mahak867/unskinny/out/unskinny_mk2_assembly.step

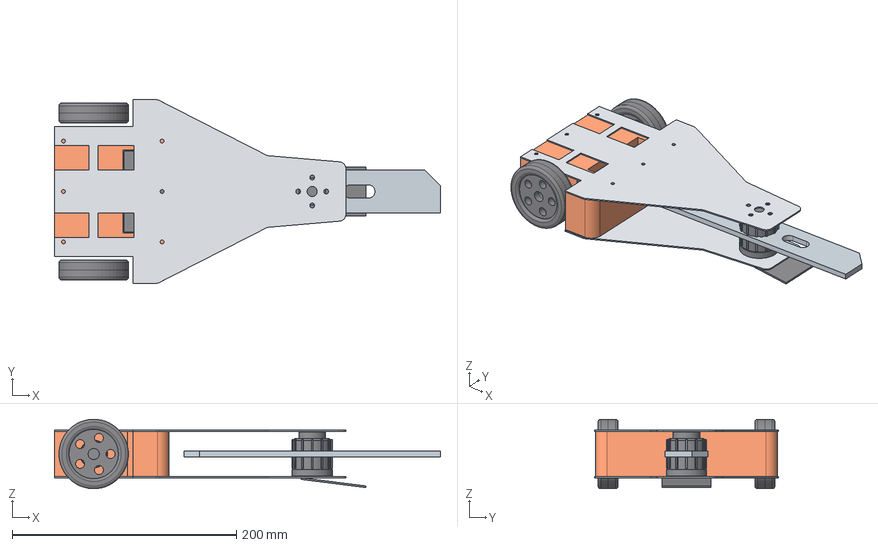
[picture p19: CAD file, 2026-11-07]
out/unskinny_mk2_assembly.step
344.5 x 164.0 x 62.0 mm
bar
top_plate
bottom_plate
frame
fork
hub_motor
battery
wheel_0
wheel_1
drive_0
drive_1
