mahak867/unskinny/out/bar.step

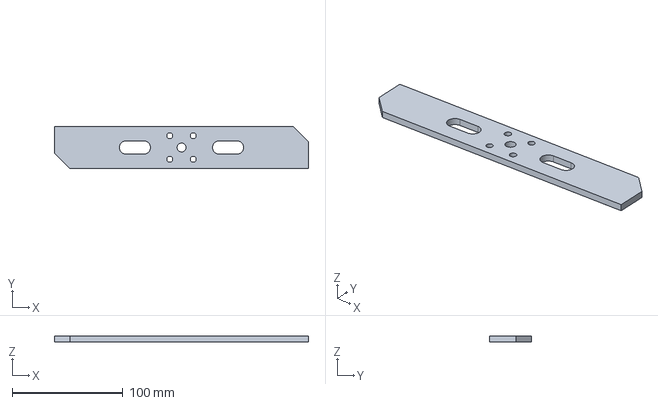
[picture p20: CAD file, 2026-11-07]
out/bar.step
229.0 x 38.0 x 5.00 mm
