mahak867/unskinny/out/frame.step

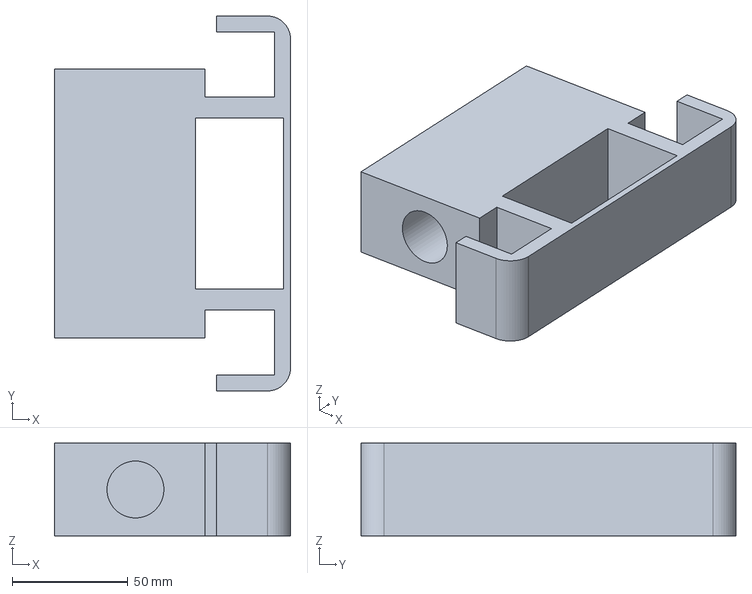
[picture p21: CAD file, 2026-11-07]
out/frame.step
102.0 x 162.0 x 40.0 mm
