mahak867/unskinny/out/bottom_plate.step

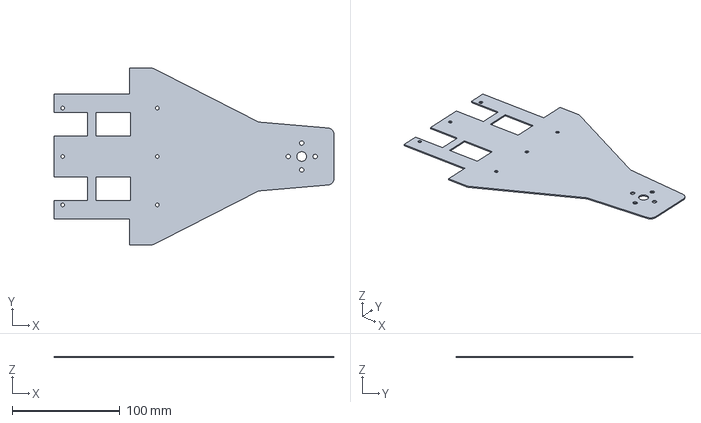
[picture p22: CAD file, 2026-11-07]
out/bottom_plate.step
260.0 x 164.0 x 1.20 mm
