mahak867/unskinny/out/wheel_0.stl

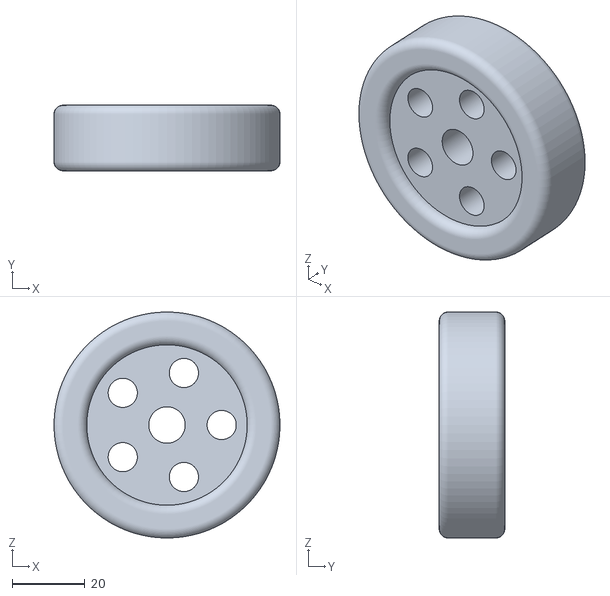
[picture p23: CAD file, 2026-11-07]
out/wheel_0.stl
62.0 x 18.0 x 62.0
