mahak867/unskinny/out/detail_switch.stl

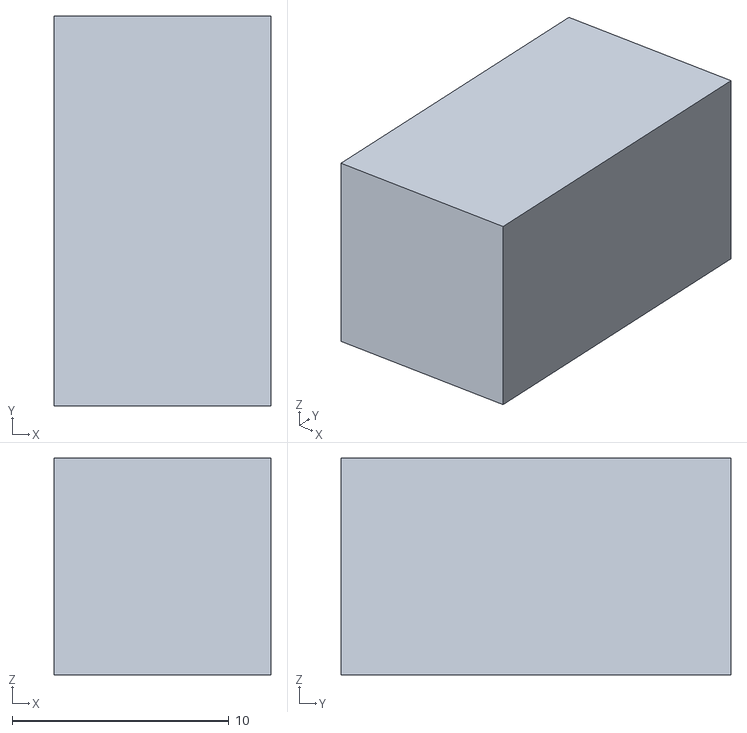
[picture p24: CAD file, 2026-11-07]
out/detail_switch.stl
10.0 x 18.0 x 10.0
