mahak867/unskinny/out/detail_esc_1.stl

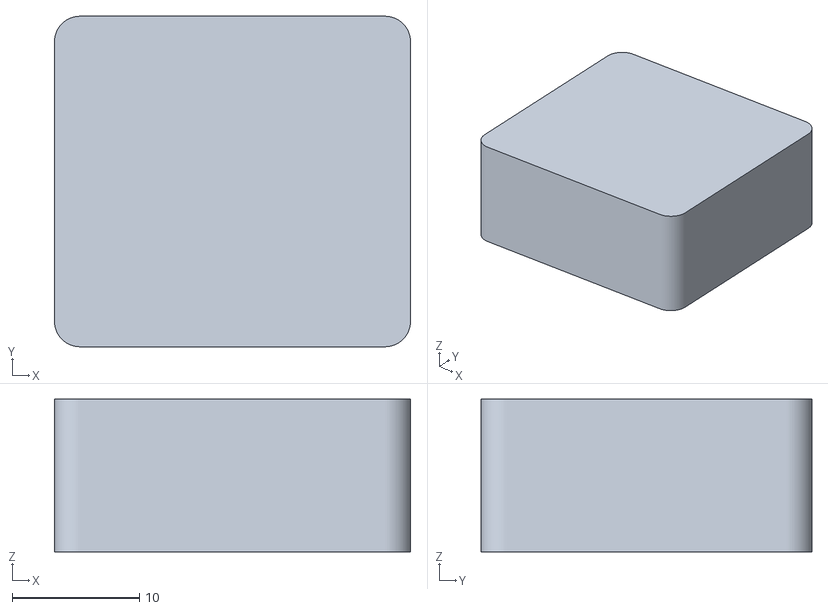
[picture p25: CAD file, 2026-11-07]
out/detail_esc_1.stl
28.0 x 26.0 x 12.0
