mahak867/unskinny/out/hub_motor.stl

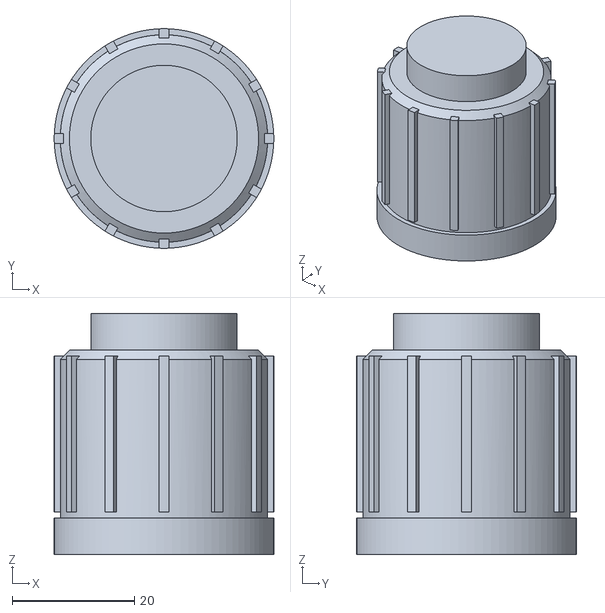
[picture p26: CAD file, 2026-11-07]
out/hub_motor.stl
36.0 x 36.0 x 39.5
