mahak867/unskinny/out/detail_receiver.stl

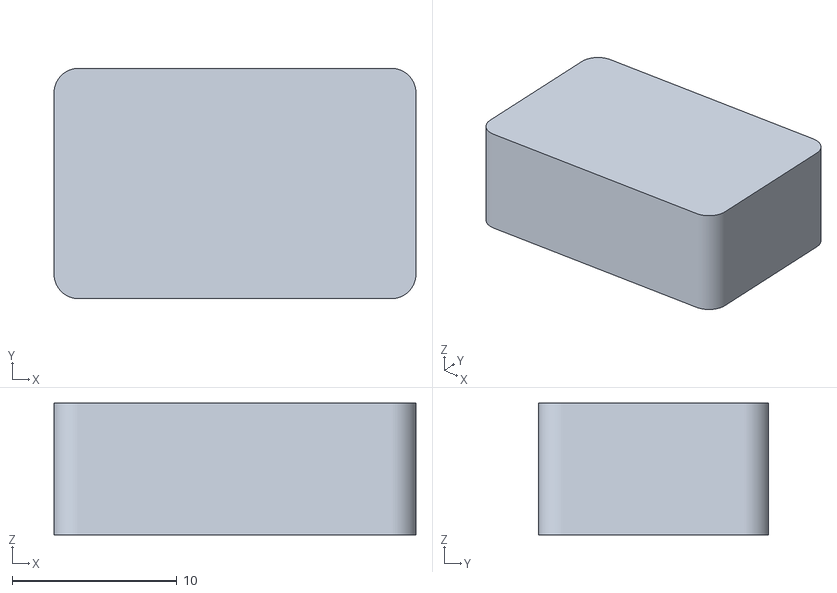
[picture p27: CAD file, 2026-11-07]
out/detail_receiver.stl
22.0 x 14.0 x 8.00
