mahak867/unskinny/out/drive_1.stl

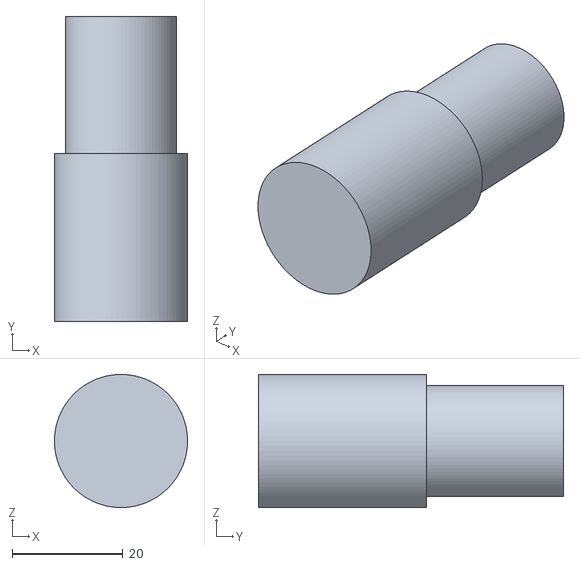
[picture p28: CAD file, 2026-11-07]
out/drive_1.stl
24.0 x 55.0 x 24.0
