mahak867/unskinny/out/battery.stl

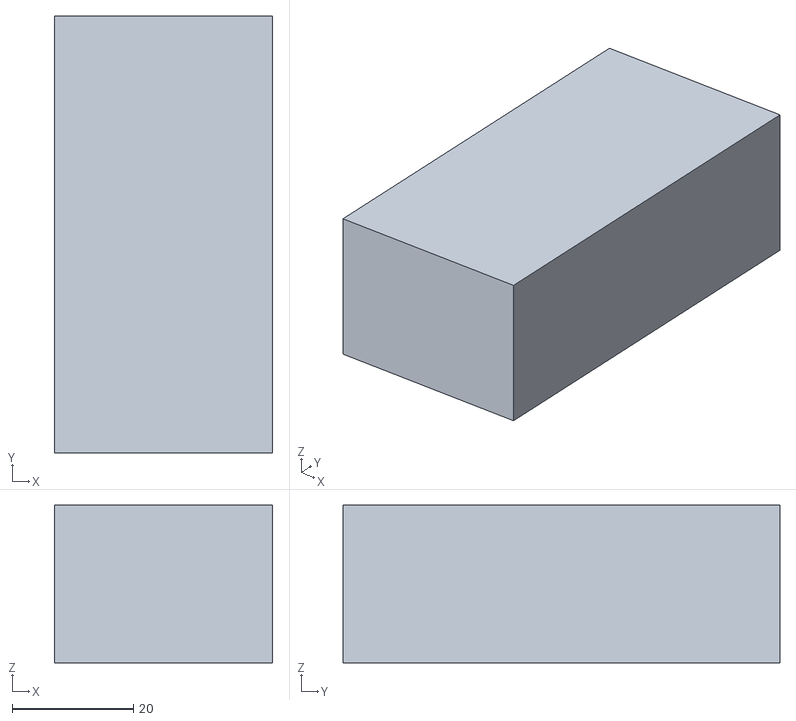
[picture p29: CAD file, 2026-11-07]
out/battery.stl
36.0 x 72.0 x 26.0
