mahak867/unskinny/out/fork.stl

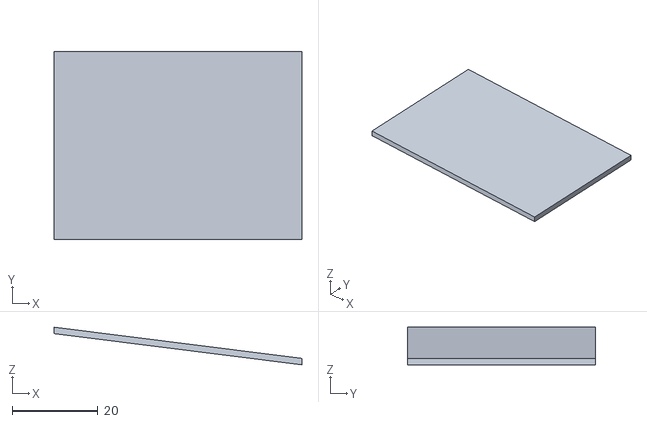
[picture p30: CAD file, 2026-11-07]
out/fork.stl
58.0 x 44.0 x 8.80
