mahak867/unskinny/out/detail_bolts_bottom.stl

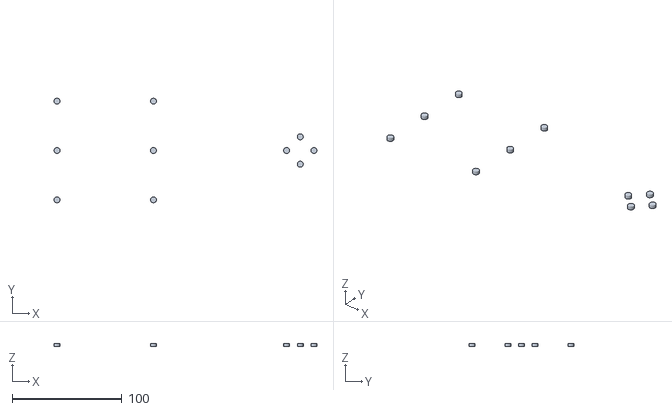
[picture p31: CAD file, 2026-11-07]
out/detail_bolts_bottom.stl
240.0 x 95.5 x 3.00
