mahak867/unskinny/out/detail_bolts_bar.stl

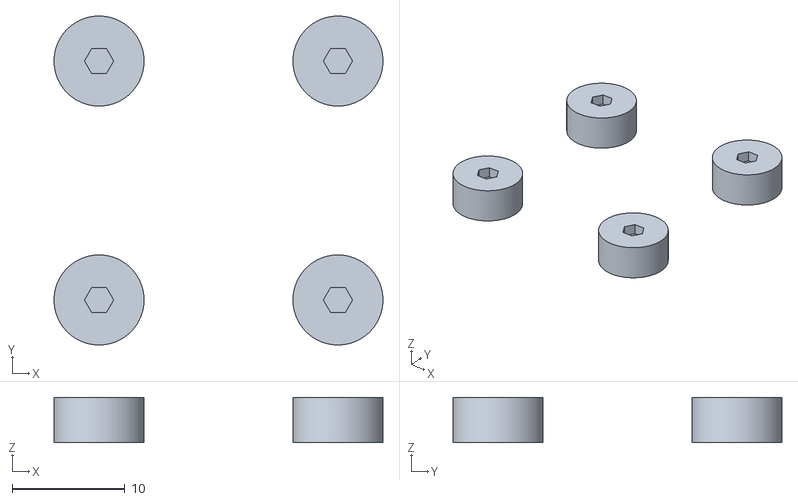
[picture p32: CAD file, 2026-11-07]
out/detail_bolts_bar.stl
29.2 x 29.2 x 4.00
