mahak867/unskinny/(list of files, cad)

Other CAD files:
out/top_plate.step
out/wheel_1.stl
out/drive_0.stl
out/detail_esc_0.stl
out/bar.dxf
out/bar.stl
out/bottom_plate.dxf
out/bottom_plate.stl
out/detail_bolts_top.stl
out/frame.stl
out/top_plate.dxf
out/top_plate.stl
