mahak867/unskinny/showcase/build-pack.html

Mk II redesign · Beetleweight 3 lb (1361 g) · horizontal bar spinner

# Unskinny Bot Build Pack

A ground-up remake of lewisb42's 2013 spinner, using the layout that wins beetleweight events today: a direct-drive brushless weapon on a hub motor, brushless geared drive, 4S power and a hardened steel bar. Everything you need to order, design, build and test is here. Tick boxes as you go; they're saved in this browser.

## 00What changed and why

Top horizontal spinners in current 3 lb brackets (for example Caldera, a horizontal midcutter, and the many bar spinners in the NHRL 2025 Championship qualifier list) share a few traits. Mk II adopts all of them.

2013 original

### Unskinny Mk I

- Belt drive, 1600 kV outrunner, no tensioner
- Aluminum bar, 6 in long
- Brushed B16 drive, 3S 1000 mAh
- Aluminum + UHMW box frame
- Belt jumps off on big hits

Mk II

### Unskinny Mk II

- Direct-drive hub motor (Repeat 2812 class): blade bolts to the motor bell, no belt or pulleys
- Hardened steel bar (AR500 or S7), ~9 in, ~300 g
- Brushless planetary drive (Repeat Max V2 class)
- 4S LiPo for more weapon and drive power
- Thick TPU frame to absorb recoil, titanium top/bottom plates
- Low, invertible profile with replaceable front forks

## 01Target specs

≤ 1340 gtarget weight (21 g margin)

229 × 38 × 5 mmAR500 bar, 304 g (from CAD)

~11,000 rpmweapon speed (simulated)

~940 Jstored weapon energy (simulated)

4S 650 mAhLiPo, 75C+ (enough for a 3 min fight)

260 × 164 × 62 mmbody footprint (from CAD)

These are design targets, not measured numbers. Check the exact kV of the hub motor you buy and rerun the calculator below. Some events cap spinner tip speed or require a test box, so check your rules first.

## 02Weapon calculator

A bar's stored energy is ½·I·ω², with I = m(L² + w²)/12. Change the values to try other bars or motors.

Bar mass (g) Bar length (mm) Bar width (mm) Motor kV Battery (cells) Loaded efficiency (%)

—loaded rpm

—tip speed

—stored energy

—moment of inertia

## 03System layout

flowchart LR
  BAT["4S LiPo 650 mAh"] --> SW["Power switch / link"]
  SW --> DESC["Dual brushless drive ESC"]
  SW --> WESC["Weapon ESC 60–80 A, 4S"]
  DESC --> ML["Left Max V2 drive"]
  DESC --> MR["Right Max V2 drive"]
  WESC --> HUB["2812 hub motor + steel bar"]
  RX["Receiver with failsafe"] -.->|"CH1/CH2 mixed"| DESC
  RX -.->|"CH3"| WESC

The weapon motor sits at the center of the chassis between the top and bottom plates, bolted through both. The battery and ESCs sit in the rear pods behind the drive motors, as far from the weapon as possible. Wheels poke out past both plates slightly so the bot drives either way up.

## 04Bill of materials

Check stock and prices before ordering. Parts listed by class with a known current example. Palm Beach Bots, Repeat Robotics and Fingertech stock most of them.

### Power and motion

Qty | Part | Example | Notes
1 | Brushless hub motor, weapon | Repeat Robotics 2812 Battle Ready Beetle Hubmotor | ~175 g, M5 weapon bolts, M4 mount pattern. Confirm kV
2 | Brushless planetary drive motor | Repeat Robotics Max V2 24 mm (2006, 2100 kV, 27:1) | Rated up to 4S with reversing ESCs
1 | Dual brushless drive ESC | Repeat or DualSky combat dual ESC | Must support reversing and 4S
1 | Weapon ESC, 60–80 A, 4S | BLHeli_32 / AM32 ESC | Set a soft start ramp so you don't brown out the drive
1 | Receiver | Matches your transmitter (FlySky, FrSky, ELRS) | Failsafe required. ELRS gives telemetry
3 | 4S 650 mAh LiPo, 75C+ | GNB, CNHL, Tattu | One in the bot, two charged spares
1 | Power switch or removable link | Fingertech switch or XT30 link | Needs to be reachable with the bot fully assembled
2 + spares | Drive wheels, ~2.25–2.5 in | Fingertech Viper or cast urethane | Hub to match the Max V2 output

### Structure and weapon

Qty | Part | Material | How to make it
1 + spare | Weapon bar, 229 × 38 × 5 mm | AR500 or S7 tool steel, hardened | Waterjet or laser from the DXF, then bevel the impact teeth
2 | Top and bottom plates | Grade 5 titanium, 1.2 mm, tapered and pocketed | Laser/waterjet (SendCutSend, OSH Cut)
1 | Main frame / unibody | TPU 95A, or Nylon-CF for the stiffer middle | 3D print, 4–6 walls, 50%+ gyroid
2 + spares | Front forks / wedgelets | Hardened steel or titanium | Bolt-on, replaceable between fights
1 set | Fasteners | Grade 12.9 M3/M4/M5 socket caps, threaded inserts | Blue threadlocker on all metal-to-metal threads
1 set | Wire, connectors | 14–16 AWG silicone wire, XT30, heat-shrink | Keep runs short

## 05Weight budget

Weigh every part as it arrives and fill in the real numbers. Estimated values are marked "est."

Item | Grams

## 06Design phase (CAD)

- Download STEP models for the hub motor, Max V2 and ESCs (Repeat Robotics publishes CAD on GrabCAD).
- Model the hub motor at the chassis center. Bar clearance should be at least 3 mm to the plates and forks.
- Place drive motors behind the weapon, wheels sticking out past both plates by ~2 mm so the bot drives upside down.
- Pack the battery and ESCs in the rear pods with foam. Leave space for wire bends.
- Design the bar: two impact teeth on opposite ends, balanced to within 1 g side to side. Use the calculator for energy.
- Use CAD mass properties with real densities (steel 7.85, Ti 4.43, TPU 1.21 g/cm³). The total must be ≤ 1340 g.
- Export DXFs for the bar, plates and forks, and STLs for the frame. Order two of each metal part.

## 07Build sequence

- Print the frame in TPU. Install heat-set threaded inserts for the plate screws.
- Deburr the cut parts. Tap the plates where needed. Grind bevels on the bar's teeth, then balance it on a knife edge or a balancer.
- Mount the drive. Fit the Max V2 motors into the frame and press on the wheels and hubs.
- Mount the weapon. Bolt the hub motor stator to the bottom plate, then the top plate. Bolt the bar to the bell with M5 grade 12.9 screws and threadlocker.
- Wire it. Solder per the layout above, with every joint heat-shrunk. Mount the switch where you can reach it.
- Secure the electronics. Foam-pack the ESCs and battery, and strap the battery down.
- Fit the forks and adjust their height so they sit just above the floor.
- Weigh it. Update the weight budget. Over 1361 g? Trim the frame infill or the fork size first, never the bar.

## 08Testing

- Bind the receiver and set failsafe to off on all channels. Check it by switching off the transmitter.
- Configure the ESCs: drive reversing, weapon ramp-up (about 1–2 s to full), direction.
- Drive test with the bar removed. Check both ways up.
- Spin up the weapon in a closed test box, in steps: 25%, 50%, full. Watch for vibration.
- Measure loaded rpm with a tachometer or ESC telemetry. Compare with the calculator.
- Run a full 3-minute session and check motor, ESC and battery temperatures.
- Do sparring hits against a test target. Check every bolt afterwards.

## 09Event day

- Pass the weigh-in with the heaviest fork set fitted.
- Pack spares: bar, forks, wheels, drive motor, ESC, receiver, 3 batteries, fasteners.
- Bring tools: hex drivers, threadlocker, soldering iron, LiPo charger and fireproof bag, zip ties, tape.
- Between fights: charge, check all bolts, inspect the bar teeth and the wheels.

Safety: a 750 J steel bar can seriously injure someone. Only spin it inside an enclosure, always arm and disarm with the bot pointed away from people, and charge LiPos in a fireproof bag.

## 10Sources

- Original Unskinny Bot guide (lewisb42, Instructables) (https://www.instructables.com/Unskinny-Bot-3-lb-Horizontal-Spinner-Combat-Bot/)
- NHRL 2025 Championships: 3 lb qualifiers (https://wiki.nhrl.io/wiki/index.php?title=2025_Championships)
- Repeat Robotics 2812 Battle Ready Beetle Hubmotor (https://palmbeachbots.com/products/repeat-robotics-2812-battle-ready-beetle-hubmotor)
- Repeat Robotics Max V2 24 mm brushless planetary drive (https://reach.dog/shop/palm-beach-bots/products/repeat-robotics-max-v2-24mm-brushless-planetary-motor-beetle-drive)
- Repeat Robotics CAD models (GrabCAD) (https://cad.grabcad.com/repeat.robotics-1/models?page=1)
- Ask Aaron: weapon design Q&A (https://runamok.tech/AskAaron/weapon.html)

Clear all checkmarks
