mahak867/unskinny/(commit log)

2026-11-07 Unskinny Mk II: parametric CAD, physics simulations and design tests
    [bar.dxf, bar.step, bar.stl, battery.stl, bottom_plate.dxf, bottom_plate.step, bottom_plate.stl, drive_0.stl]
2026-11-07 Detailed CAD parts and upgraded 3D viewer
    [bar.dxf, bar.step, bar.stl, bottom_plate.dxf, bottom_plate.step, bottom_plate.stl, detail_bolts_bar.stl, detail_bolts_bottom.stl]
2026-11-07 Builder package: part drawings, wiring diagram, exploded assembly, 16-page PDF, design upgrades
    [bar.dxf, bar.step, bottom_plate.dxf, bottom_plate.step, frame.step, top_plate.dxf, top_plate.step, unskinny_mk2_assembly.step]
